jahoyosr/Aeropendulum/Model identification and software development/20161012_181107.jpg

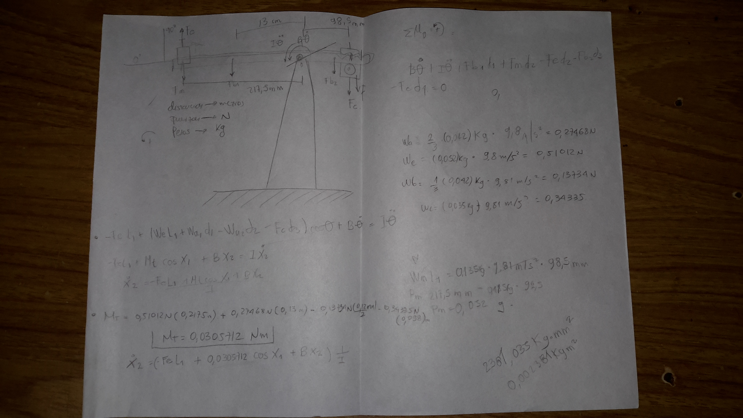
Model identification and software development/20161012_181107.jpg
