jahoyosr/Aeropendulum/Model identification and software development/ModeloMatlab/helice_ipt_be61535d.STL

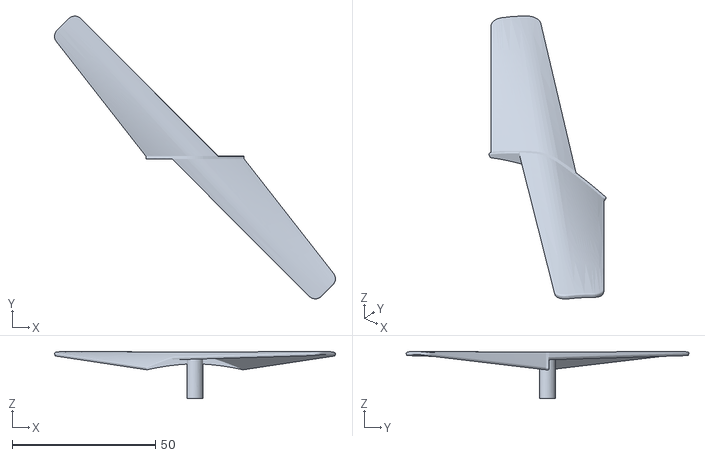
[picture p23: CAD file, 2020-12-21]
Model identification and software development/ModeloMatlab/helice_ipt_be61535d.STL
97.9 x 98.5 x 16.4
