jahoyosr/Aeropendulum/Model identification and software development/ModeloMatlab/baseUnida_ipt_1244857d.STL

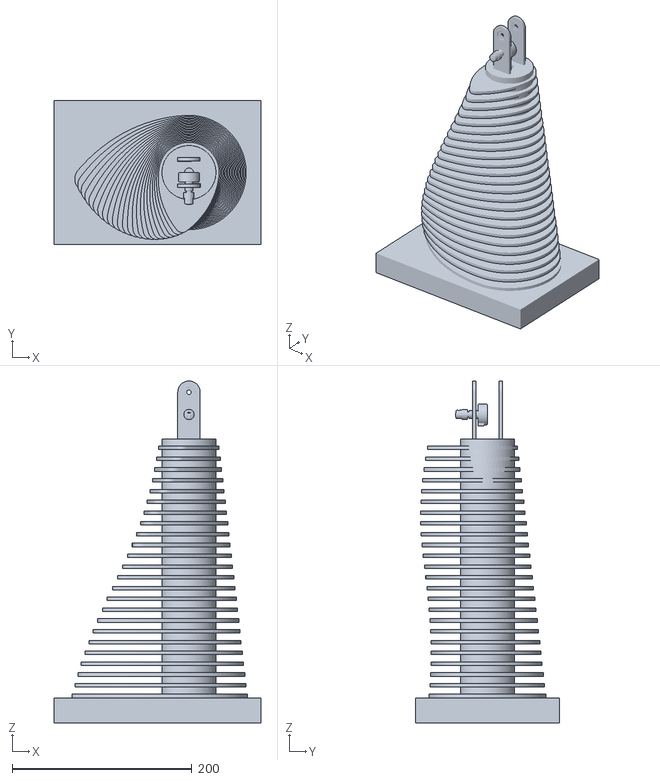
[picture p24: CAD file, 2020-12-21]
Model identification and software development/ModeloMatlab/baseUnida_ipt_1244857d.STL
230.0 x 160.0 x 380.4
