jahoyosr/Aeropendulum/Model identification and software development/ModeloMatlab/Pieza2_ipt_8f5fd960.STL

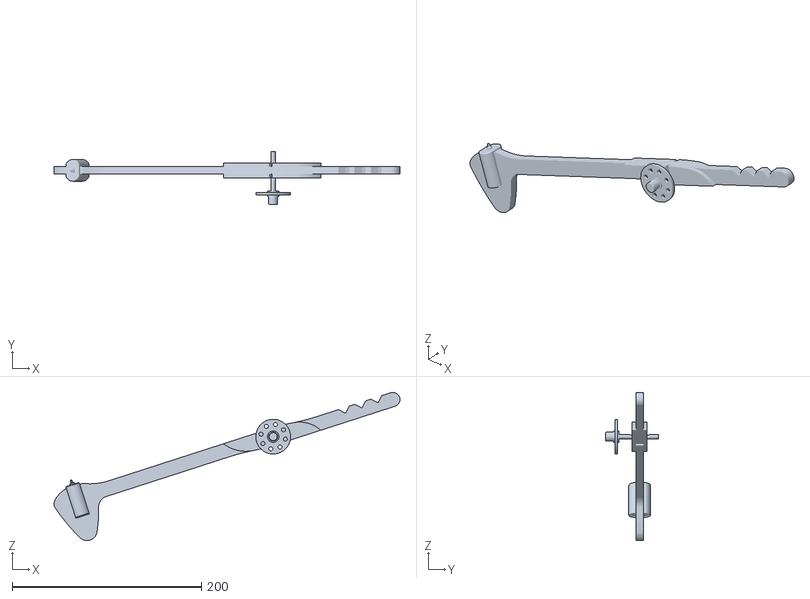
[picture p25: CAD file, 2020-12-21]
Model identification and software development/ModeloMatlab/Pieza2_ipt_8f5fd960.STL
365.7 x 56.1 x 156.6
