jahoyosr/Aeropendulum/(list of files, cad)

Other CAD files:
CAD/Templates/Inglés/am_ansi.dwg
CAD/Templates/Métrico/am_iso.dwg
CAD/Templates/Normal.dwg
CAD/Templates/Inglés/ANSI (pul).dwg
CAD/Templates/Métrico/GB.dwg
CAD/Templates/Métrico/BSI.dwg
CAD/Templates/Métrico/DIN.dwg
CAD/Templates/Métrico/GOST.dwg
CAD/Templates/Métrico/am_bsi.dwg
CAD/Templates/Métrico/am_gb.dwg
CAD/Templates/Métrico/ANSI (mm).dwg
CAD/Templates/Métrico/am_jis.dwg
CAD/Templates/Métrico/ISO.dwg
CAD/Templates/Métrico/JIS.dwg
CAD/Templates/Métrico/am_din.dwg
CAD/Design Data/AIT/Mold Design/mold design stop pin.ipt
CAD/Design Data/Cable & Harness/es-ES/harness.iam
CAD/Design Data/Tube & Pipe/es-ES/piping runs.iam
CAD/MotorCesar.ipt
CAD/Planta.iam
CAD/Templates/Chapa.ipt
CAD/Templates/Conjunto soldado.iam
CAD/Templates/Inglés/ANSI (pul).idw
CAD/Templates/Inglés/Chapa (pul).ipt
CAD/Templates/Inglés/Conjunto soldado (ANSI).iam
CAD/Templates/Inglés/Mold Design (pul).iam
CAD/Templates/Inglés/Normal (pul).iam
CAD/Templates/Inglés/Normal (pul).ipn
CAD/Templates/Inglés/Normal (pul).ipt
CAD/Templates/Mold Design/Mold Design.iam
CAD/Templates/Métrico/ANSI (mm).idw
CAD/Templates/Métrico/BSI.idw
CAD/Templates/Métrico/Chapa (DIN).ipt
CAD/Templates/Métrico/Chapa (mm).ipt
CAD/Templates/Métrico/Conjunto soldado (ANSI - mm).iam
CAD/Templates/Métrico/Conjunto soldado (BSI).iam
CAD/Templates/Métrico/Conjunto soldado (DIN).iam
CAD/Templates/Métrico/Conjunto soldado (GB).iam
CAD/Templates/Métrico/Conjunto soldado (ISO).iam
CAD/Templates/Métrico/Conjunto soldado (JIS).iam
CAD/Templates/Métrico/DIN.idw
CAD/Templates/Métrico/GB.idw
CAD/Templates/Métrico/GOST.idw
CAD/Templates/Métrico/ISO.idw
CAD/Templates/Métrico/JIS.idw
CAD/Templates/Métrico/Mold Design (DIN).iam
CAD/Templates/Métrico/Mold Design (mm).iam
CAD/Templates/Métrico/Normal (DIN).iam
CAD/Templates/Métrico/Normal (DIN).ipn
CAD/Templates/Métrico/Normal (DIN).ipt
CAD/Templates/Métrico/Normal (mm).iam
CAD/Templates/Métrico/Normal (mm).ipn
CAD/Templates/Métrico/Normal (mm).ipt
CAD/Templates/Normal.iam
CAD/Templates/Normal.idw
CAD/Templates/Normal.ipn
CAD/Templates/Normal.ipt
CAD/balancin.ipt
CAD/balancinRefuerzos.ipt
CAD/base.ipt
CAD/base1.ipt
CAD/base2.ipt
CAD/base3.ipt
CAD/columna01.ipt
CAD/columna02.ipt
CAD/eje.ipt
CAD/engraneGrande.ipt
CAD/engranePeq.ipt
CAD/entreCapa8mm.ipt
CAD/helice.ipt
CAD/leva00 - copia (10).ipt
CAD/leva00 - copia (11).ipt
CAD/leva00 - copia (12).ipt
CAD/leva00 - copia (13).ipt
CAD/leva00 - copia (14).ipt
CAD/leva00 - copia (15).ipt
CAD/leva00 - copia (16).ipt
CAD/leva00 - copia (17).ipt
CAD/leva00 - copia (18).ipt
CAD/leva00 - copia (19).ipt
CAD/leva00 - copia (2).ipt
CAD/leva00 - copia (20).ipt
CAD/leva00 - copia (21).ipt
CAD/leva00 - copia (22).ipt
CAD/leva00 - copia (23).ipt
CAD/leva00 - copia (3).ipt
CAD/leva00 - copia (4).ipt
CAD/leva00 - copia (5).ipt
CAD/leva00 - copia (6).ipt
CAD/leva00 - copia (7).ipt
CAD/leva00 - copia (8).ipt
CAD/leva00 - copia (9).ipt
CAD/leva00 - copia.ipt
CAD/leva00.ipt
CAD/potenciometro.ipt
CAD/rodamiento.ipt
