jahoyosr/Aeropendulum/Model identification and software development/programaVvsF/programaVvsF.ino

#define in1 6     // Control pin 1 para motor 1
#define in2 7     // Control pin 2 para motor 1

int i=0;
double grados=0;

void setup()
   {
   // inicializar puerto serie
   Serial.begin(9600);
        pinMode( in1, OUTPUT);
        pinMode( in2, OUTPUT);


        digitalWrite(in1, LOW);     // paramos motor 1
        digitalWrite(in2, LOW);
        
   }
void loop()
   {    
      
        analogWrite(in2, 150);     // Arrancamos motor 1 para que sople hacia abajo 
        digitalWrite(in1, LOW);
       
       // leer pines
       grados = -0.093*analogRead(A0)+42.677;
       Serial.println(grados);

        
   }
