jahoyosr/Aeropendulum/Model identification and software development/lecturaDedos_ert_rtw/ert_main.c

/*
 * File: ert_main.c
 *
 * Code generated for Simulink model 'lecturaDedos'.
 *
 * Model version                  : 1.1
 * Simulink Coder version         : 8.10 (R2016a) 10-Feb-2016
 * C/C++ source code generated on : Fri Nov 11 16:32:27 2016
 *
 * Target selection: ert.tlc
 * Embedded hardware selection: Atmel->AVR
 * Code generation objectives: Unspecified
 * Validation result: Not run
 */

#include "lecturaDedos.h"
#include "rtwtypes.h"
#include <ext_work.h>
#include <ext_svr.h>
#include <ext_share.h>
#include <updown.h>

volatile int IsrOverrun = 0;
static boolean_T OverrunFlag = 0;
void rt_OneStep(void)
{
  /* Check for overrun. Protect OverrunFlag against preemption */
  if (OverrunFlag++) {
    IsrOverrun = 1;
    OverrunFlag--;
    return;
  }

#ifndef _MW_ARDUINO_LOOP_

  sei();

#endif;

  lecturaDedos_step();

  /* Get model outputs here */
#ifndef _MW_ARDUINO_LOOP_

  cli();

#endif;

  OverrunFlag--;
  rtExtModeCheckEndTrigger();
}

int main(void)
{
  volatile boolean_T runModel = 1;
  float modelBaseRate = 0.05;
  float systemClock = 0;
  init();
  MW_Arduino_Init();
  rtmSetErrorStatus(lecturaDedos_M, 0);

  /* initialize external mode */
  rtParseArgsForExtMode(0, NULL);
  lecturaDedos_initialize();
  sei();

  /* External mode */
  rtSetTFinalForExtMode(&rtmGetTFinal(lecturaDedos_M));
  rtExtModeCheckInit(1);

  {
    boolean_T rtmStopReq = false;
    rtExtModeWaitForStartPkt(lecturaDedos_M->extModeInfo, 1, &rtmStopReq);
    if (rtmStopReq) {
      rtmSetStopRequested(lecturaDedos_M, true);
    }
  }

  rtERTExtModeStartMsg();
  cli();
  configureArduinoAVRTimer();
  runModel =
    (rtmGetErrorStatus(lecturaDedos_M) == (NULL)) && !rtmGetStopRequested
    (lecturaDedos_M);

#ifndef _MW_ARDUINO_LOOP_

  sei();

#endif;

  sei();
  while (runModel) {
    /* External mode */
    {
      boolean_T rtmStopReq = false;
      rtExtModeOneStep(lecturaDedos_M->extModeInfo, 1, &rtmStopReq);
      if (rtmStopReq) {
        rtmSetStopRequested(lecturaDedos_M, true);
      }
    }

    runModel =
      (rtmGetErrorStatus(lecturaDedos_M) == (NULL)) && !rtmGetStopRequested
      (lecturaDedos_M);
    runModel = runModel && MW_Arduino_Loop();
  }

  rtExtModeShutdown(1);

  /* Disable rt_OneStep() here */

  /* Terminate model */
  lecturaDedos_terminate();
  cli();
  return 0;
}

/*
 * File trailer for generated code.
 *
 * [EOF]
 */
