jahoyosr/Aeropendulum/Model identification and software development/lecturaDedos_ert_rtw/lecturaDedos_dt.h

/*
 * lecturaDedos_dt.h
 *
 * Code generation for model "lecturaDedos".
 *
 * Model version              : 1.1
 * Simulink Coder version : 8.10 (R2016a) 10-Feb-2016
 * C source code generated on : Fri Nov 11 16:32:27 2016
 *
 * Target selection: ert.tlc
 * Embedded hardware selection: Atmel->AVR
 * Code generation objectives: Unspecified
 * Validation result: Not run
 */

#include "ext_types.h"

/* data type size table */
static uint_T rtDataTypeSizes[] = {
  sizeof(real_T),
  sizeof(real32_T),
  sizeof(int8_T),
  sizeof(uint8_T),
  sizeof(int16_T),
  sizeof(uint16_T),
  sizeof(int32_T),
  sizeof(uint32_T),
  sizeof(boolean_T),
  sizeof(fcn_call_T),
  sizeof(int_T),
  sizeof(pointer_T),
  sizeof(action_T),
  2*sizeof(uint32_T)
};

/* data type name table */
static const char_T * rtDataTypeNames[] = {
  "real_T",
  "real32_T",
  "int8_T",
  "uint8_T",
  "int16_T",
  "uint16_T",
  "int32_T",
  "uint32_T",
  "boolean_T",
  "fcn_call_T",
  "int_T",
  "pointer_T",
  "action_T",
  "timer_uint32_pair_T"
};

/* data type transitions for block I/O structure */
static DataTypeTransition rtBTransitions[] = {
  { (char_T *)(&lecturaDedos_B.AnalogInput), 5, 0, 2 }
  ,

  { (char_T *)(&lecturaDedos_DW.Scope_PWORK.LoggedData[0]), 11, 0, 2 }
};

/* data type transition table for block I/O structure */
static DataTypeTransitionTable rtBTransTable = {
  2U,
  rtBTransitions
};

/* data type transitions for Parameters structure */
static DataTypeTransition rtPTransitions[] = {
  { (char_T *)(&lecturaDedos_P.AnalogInput_p1), 7, 0, 2 }
};

/* data type transition table for Parameters structure */
static DataTypeTransitionTable rtPTransTable = {
  1U,
  rtPTransitions
};

/* [EOF] lecturaDedos_dt.h */
